SyEpm/crkbd_hardware/3d-cases/crkbd-STL/images/case2v2.png

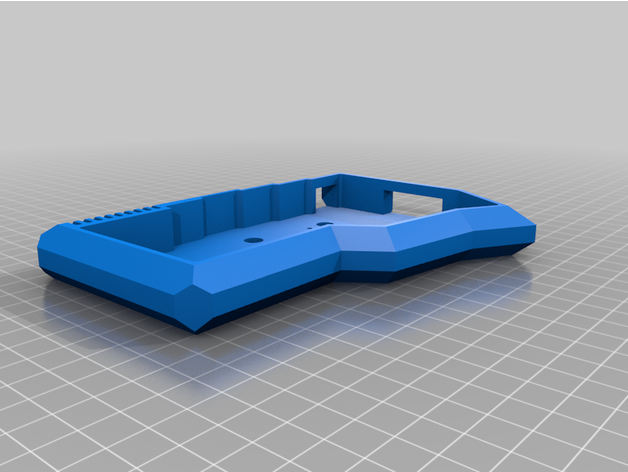
3d-cases/crkbd-STL/images/case2v2.png
