SyEpm/crkbd_hardware/3d-cases/crkbd-STL/images/20191211_113759.jpg

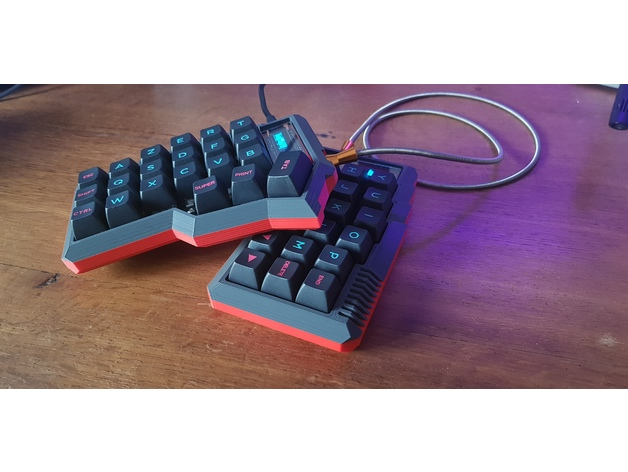
3d-cases/crkbd-STL/images/20191211_113759.jpg
