SyEpm/crkbd_hardware/README.md

# crkbd_hardware
Versiones de CorneKeyboard y carcazas
