SyEpm/crkbd_hardware/3d-cases/crkbd-STL/README.txt

CRKBD / Corne Keyboard Case v2 by Coumbaya on Thingiverse: https://www.thingiverse.com/thing:4283322
