SyEpm/crkbd_hardware/3d-cases/crkbd-STL/images/case2v2_r.png

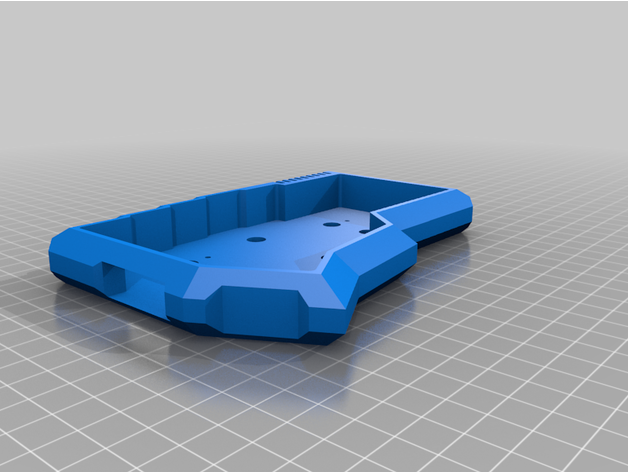
3d-cases/crkbd-STL/images/case2v2_r.png
