SyEpm/crkbd_hardware/3d-cases/crkbd-STL/files/case2v2.STEP

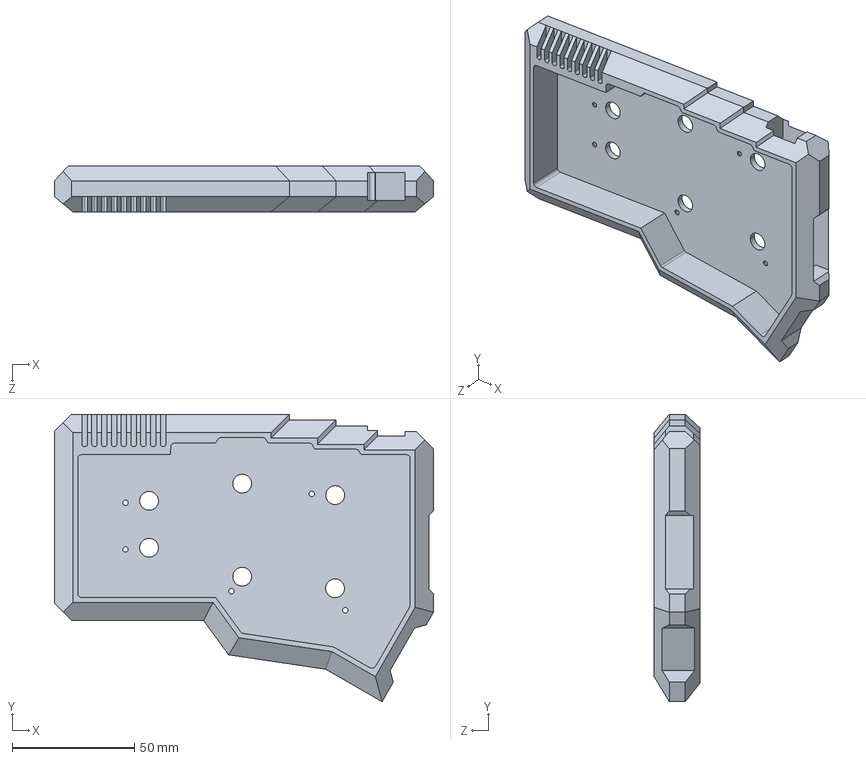
[picture p4: CAD file, 2021-07-21]
3d-cases/crkbd-STL/files/case2v2.STEP
154.8 x 117.4 x 18.7 mm
