SyEpm/crkbd_hardware/corne-cherry-v3.0.1/plates/mini-tilting-tenting/top-bottom.dxf

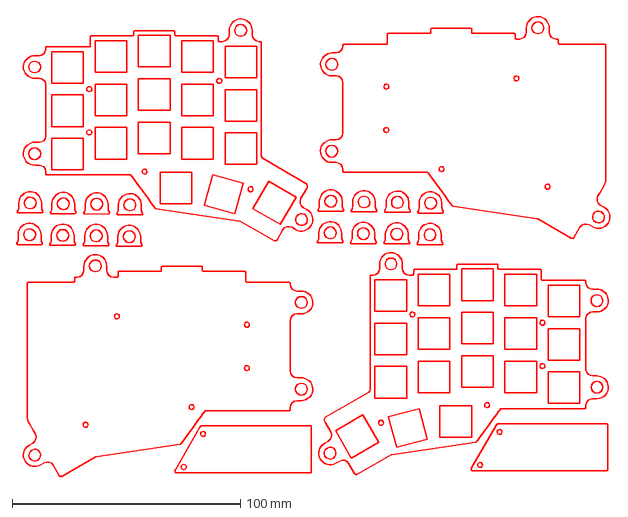
[picture p5: CAD file, 2021-07-21]
corne-cherry-v3.0.1/plates/mini-tilting-tenting/top-bottom.dxf
261.0 x 202.0 mm
