SyEpm/crkbd_hardware/corne-cherry-v3.0.1/plates/mini/top-bottom.dxf

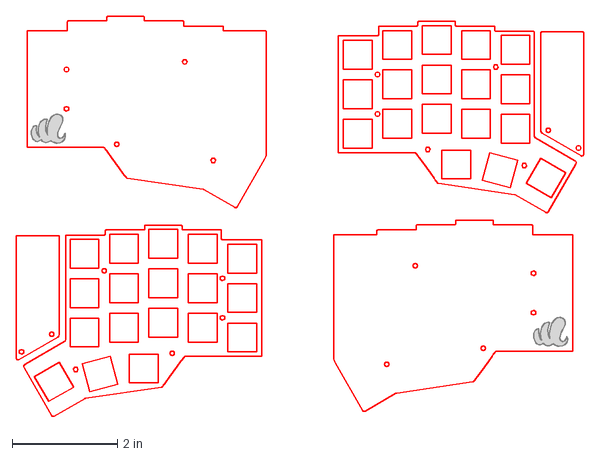
[picture p6: CAD file, 2021-07-21]
corne-cherry-v3.0.1/plates/mini/top-bottom.dxf
10.8 x 7.60 in
