SyEpm/crkbd_hardware/corne-cherry-v3.0.1/plates/tilting-tenting/tilting-tenting_top-bottom.dxf

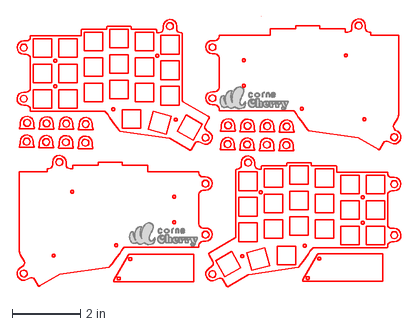
[picture p7: CAD file, 2021-07-21]
corne-cherry-v3.0.1/plates/tilting-tenting/tilting-tenting_top-bottom.dxf
11.3 x 7.93 in
