SyEpm/crkbd_hardware/corne-classic-v2.0.0/plates/cherry/top-bottom.dxf

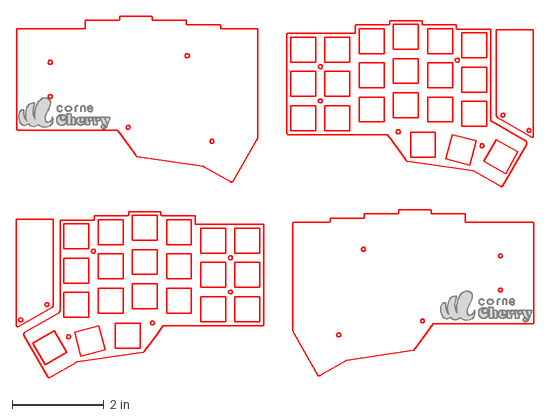
[picture p8: CAD file, 2021-07-21]
corne-classic-v2.0.0/plates/cherry/top-bottom.dxf
11.3 x 7.91 in
