SyEpm/crkbd_hardware/corne-classic-v2.0.0/plates/chocolate/top-bottom.dxf

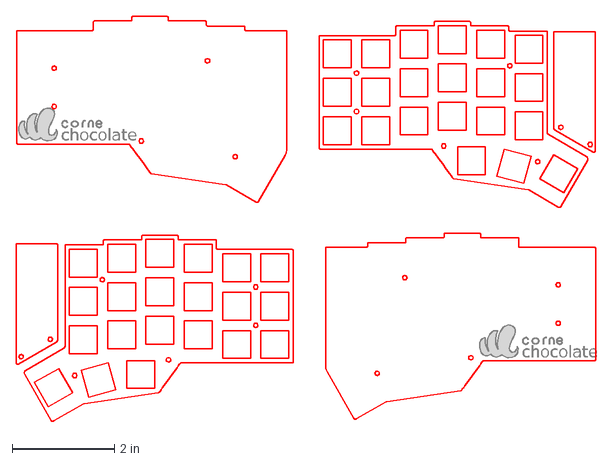
[picture p9: CAD file, 2021-07-21]
corne-classic-v2.0.0/plates/chocolate/top-bottom.dxf
chocolate
