SyEpm/crkbd_hardware/corne-classic-v2.0.0/plates/imk/imk_top-bottom.dxf

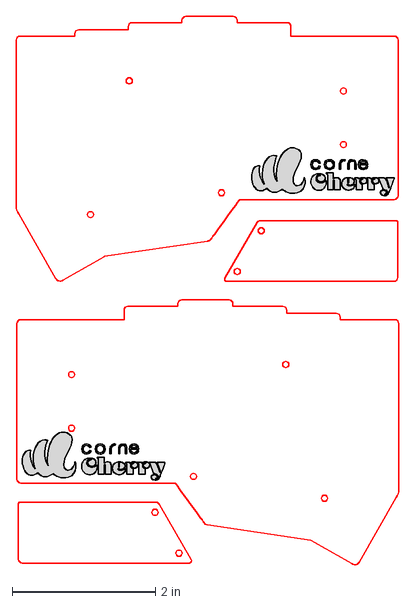
[picture p10: CAD file, 2021-07-21]
corne-classic-v2.0.0/plates/imk/imk_top-bottom.dxf
5.35 x 7.67 in
