SyEpm/crkbd_hardware/(list of files, cad)

Other CAD files:
3d-cases/crkbd-STL/files/case2v2_r.stl
3d-cases/crkbd-STL/files/case2v2-d.STEP
3d-cases/crkbd-STL/files/case2v2-d.SLDPRT
3d-cases/crkbd-STL/files/case2v2.SLDPRT
3d-cases/crkbd-STL/files/case2v2.STL
